iprotonotarios/gondola/README.md

# gondola
A parametric robot infrastructure for repeatable mobile experiments

http://arxiv.org/abs/1601.07457
