iprotonotarios/gondola/3d_parts/nema17_pulley.stl

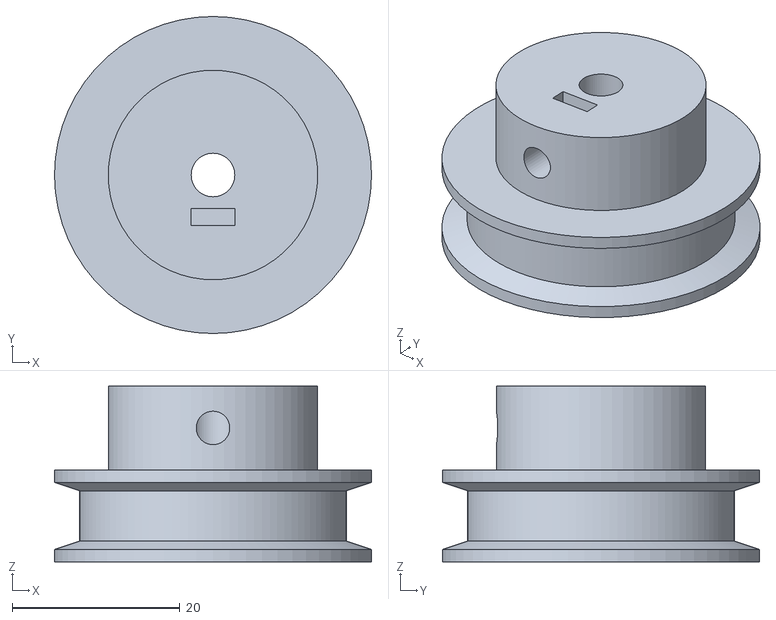
[picture p1: CAD file, 2016-10-17]
3d_parts/nema17_pulley.stl
37.8 x 37.8 x 21.0
