iprotonotarios/gondola/3d_parts/nema17_motor_base.stl

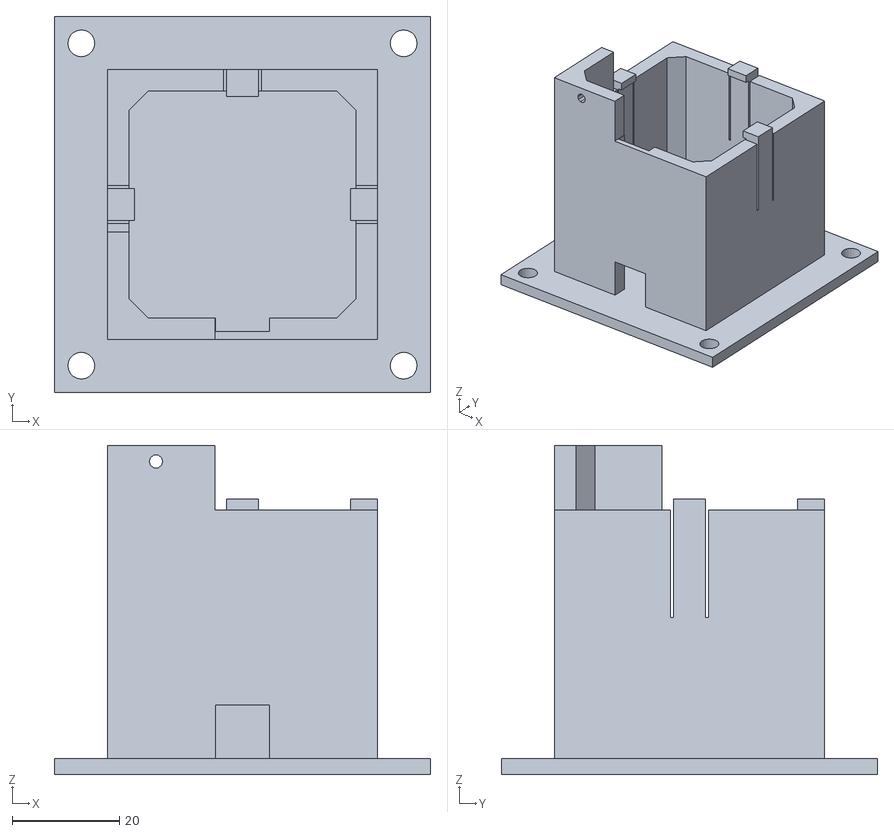
[picture p2: CAD file, 2016-01-28]
3d_parts/nema17_motor_base.stl
70.0 x 70.0 x 61.3
