iprotonotarios/gondola/(list of files, cad)

Other CAD files:
3d_parts/nema17_motor_base.scad
3d_parts/nema17_pulley.scad
