iprotonotarios/gondola/motor_controller/eagle_pcb/gondola.brd

## EAGLE design motor_controller/eagle_pcb/gondola.brd (2016-01-27)

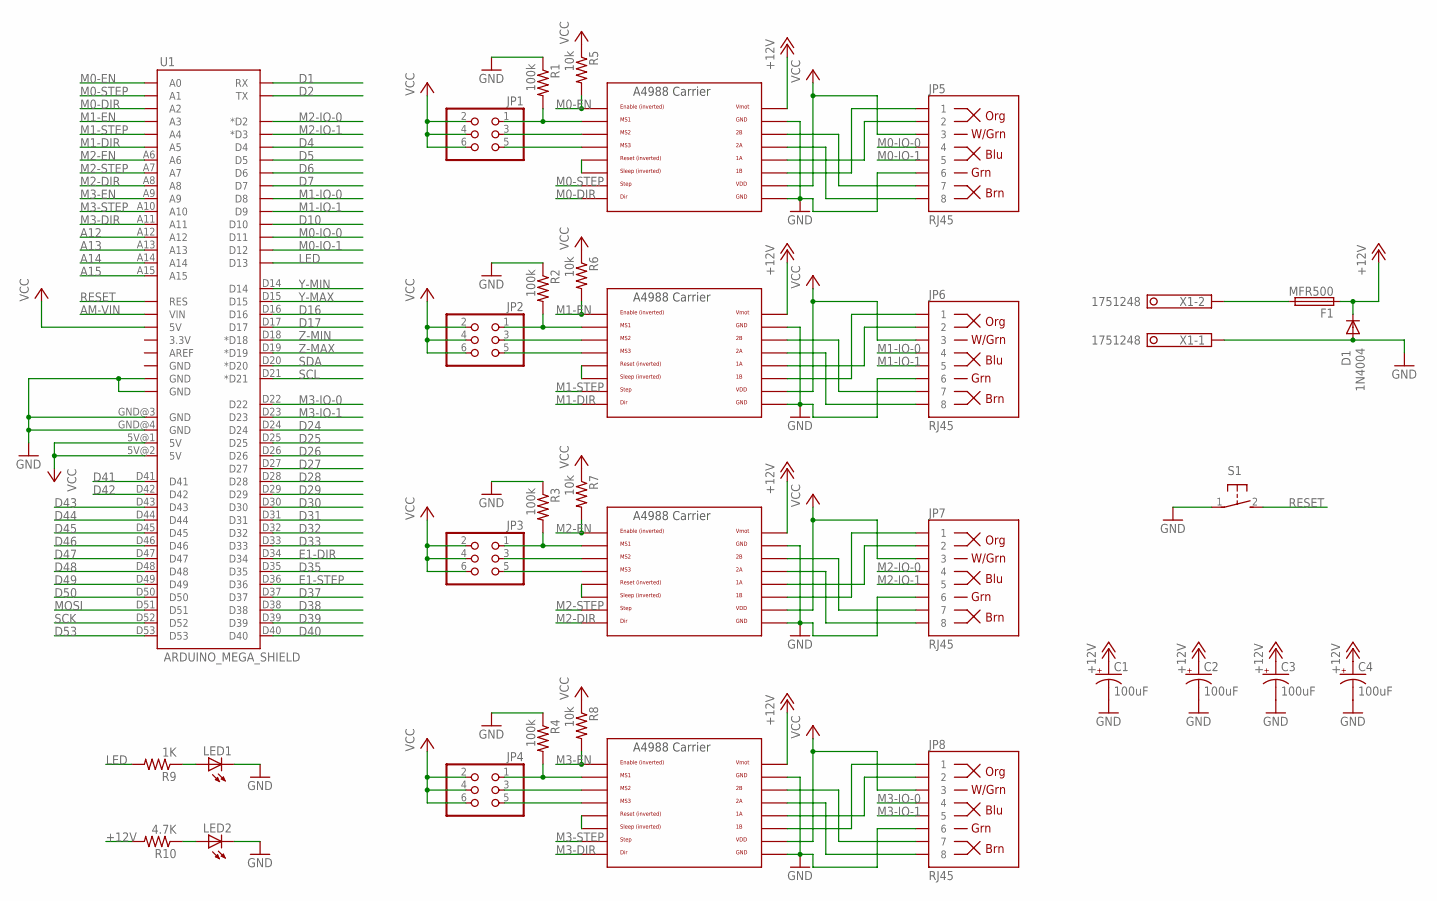
[picture p3: schematic gondola.sch]

Parts:
C1, C2, C3, C4: 100uF; 153CLV-0605
D1: 1N4004; DO41-10
F1: MFR500
JP1, JP2, JP3, JP4: PINHD-2X3; 2X03
JP5, JP6, JP7, JP8: RJ45; RJ45-8
LED1, LED2: LEDCHIP-LED0805; CHIP-LED0805
R1, R2, R3, R4: 100k; R0805
R5, R6, R7, R8: 10k; R0805
R9: 1K; R0805
R10: 4.7K; R0805
S1: 31-XX; B3F-31XX
U1: ARDUINO_MEGA_SHIELD
U$1, U$2, U$3, U$4: A4988BREAKOUT
X1: 1751248

Connections:
+12V: C1.+, C2.+, C3.+, C4.+, D1.C, F1.1, R10.2, U$1.VMOT, U$2.VMOT, U$3.VMOT, U$4.VMOT
A12: U1.A12
A13: U1.A13
A14: U1.A14
A15: U1.A15
AM-VIN: U1.VIN
D1: U1.RX
D2: U1.TX
D4: U1.D4
D5: U1.D5
D6: U1.D6
D7: U1.D7
D10: U1.D10
D16: U1.D16
D17: U1.D17
D24: U1.D24
D25: U1.D25
D26: U1.D26
D27: U1.D27
D28: U1.D28
D29: U1.D29
D30: U1.D30
D31: U1.D31
D32: U1.D32
D33: U1.D33
D35: U1.D35
D37: U1.D37
D38: U1.D38
D39: U1.D39
D40: U1.D40
D41: U1.D41
D42: U1.D42
D43: U1.D43
D44: U1.D44
D45: U1.D45
D46: U1.D46
D47: U1.D47
D48: U1.D48
D49: U1.D49
D50: U1.D50
D53: U1.D53
E1-DIR: U1.D34
E1-STEP: U1.D36
GND: C1.-, C2.-, C3.-, C4.-, D1.A, JP5.6, JP6.6, JP7.6, JP8.6, LED1.C, LED2.C, R1.1, R2.1, R3.1, R4.1, S1.1, U1.GND@0 (GND), U1.GND@1 (GND), U1.GND@3 (GND), U1.GND@4 (GND), U$1.GND, U$1.GND@0 (GND), U$2.GND, U$2.GND@0 (GND), U$3.GND, U$3.GND@0 (GND), U$4.GND, U$4.GND@0 (GND), X1.1
LED: R9.2, U1.D13
M0-DIR: U1.A2, U$4.DIR
M0-EN: R5.2, U1.A0, U$4.EN
M0-IO-0: JP5.4, U1.D11
M0-IO-1: JP5.5, U1.D12
M0-STEP: U1.A1, U$4.STEP
M1-DIR: U1.A5, U$1.DIR
M1-EN: R6.2, U1.A3, U$1.EN
M1-IO-0: JP6.4, U1.D8
M1-IO-1: JP6.5, U1.D9
M1-STEP: U1.A4, U$1.STEP
M2-DIR: U1.A8, U$2.DIR
M2-EN: R7.2, U1.A6, U$2.EN
M2-IO-0: JP7.4, U1.D2 (*D2)
M2-IO-1: JP7.5, U1.D3 (*D3)
M2-STEP: U1.A7, U$2.STEP
M3-DIR: U1.A11, U$3.DIR
M3-EN: R8.2, U1.A9, U$3.EN
M3-IO-0: JP8.4, U1.D22
M3-IO-1: JP8.5, U1.D23
M3-STEP: U1.A10, U$3.STEP
MOSI: U1.D51
unnamed: JP2.5, U$1.MS3
unnamed: U$1.RST, U$1.SLP (SLEEP)
unnamed: JP1.5, U$4.MS3
unnamed: U$4.RST, U$4.SLP (SLEEP)
unnamed: JP1.1, R1.2, U$4.MS1
unnamed: JP1.3, U$4.MS2
unnamed: JP2.1, R2.2, U$1.MS1
unnamed: JP6.7, U$1.2B
unnamed: JP6.8, U$1.2A
unnamed: JP6.1, U$1.1B
unnamed: JP6.2, U$1.1A
unnamed: JP2.3, U$1.MS2
unnamed: JP5.7, U$4.2B
unnamed: JP5.8, U$4.2A
unnamed: JP5.1, U$4.1B
unnamed: JP5.2, U$4.1A
unnamed: JP3.5, U$2.MS3
unnamed: U$2.RST, U$2.SLP (SLEEP)
unnamed: JP3.1, R3.2, U$2.MS1
unnamed: JP3.3, U$2.MS2
unnamed: JP7.7, U$2.2B
unnamed: JP7.8, U$2.2A
unnamed: JP7.1, U$2.1B
unnamed: JP7.2, U$2.1A
unnamed: JP4.5, U$3.MS3
unnamed: U$3.RST, U$3.SLP (SLEEP)
unnamed: JP4.1, R4.2, U$3.MS1
unnamed: JP4.3, U$3.MS2
unnamed: JP8.7, U$3.2B
unnamed: JP8.8, U$3.2A
unnamed: JP8.2, U$3.1A
unnamed: JP8.1, U$3.1B
unnamed: LED2.A, R10.1
unnamed: LED1.A, R9.1
unnamed: F1.2, X1.2
RESET: S1.2 (S), U1.RES
SCK: U1.D52
SCL: U1.D21 (*D21)
SDA: U1.D20 (*D20)
VCC: JP1.2, JP1.4, JP1.6, JP2.2, JP2.4, JP2.6, JP3.2, JP3.4, JP3.6, JP4.2, JP4.4, JP4.6, JP5.3, JP6.3, JP7.3, JP8.3, R5.1, R6.1, R7.1, R8.1, U1.5V@0 (5V), U1.5V@1 (5V), U1.5V@2 (5V), U$1.VDD, U$2.VDD, U$3.VDD, U$4.VDD
Y-MAX: U1.D15
Y-MIN: U1.D14
Z-MAX: U1.D19 (*D19)
Z-MIN: U1.D18 (*D18)

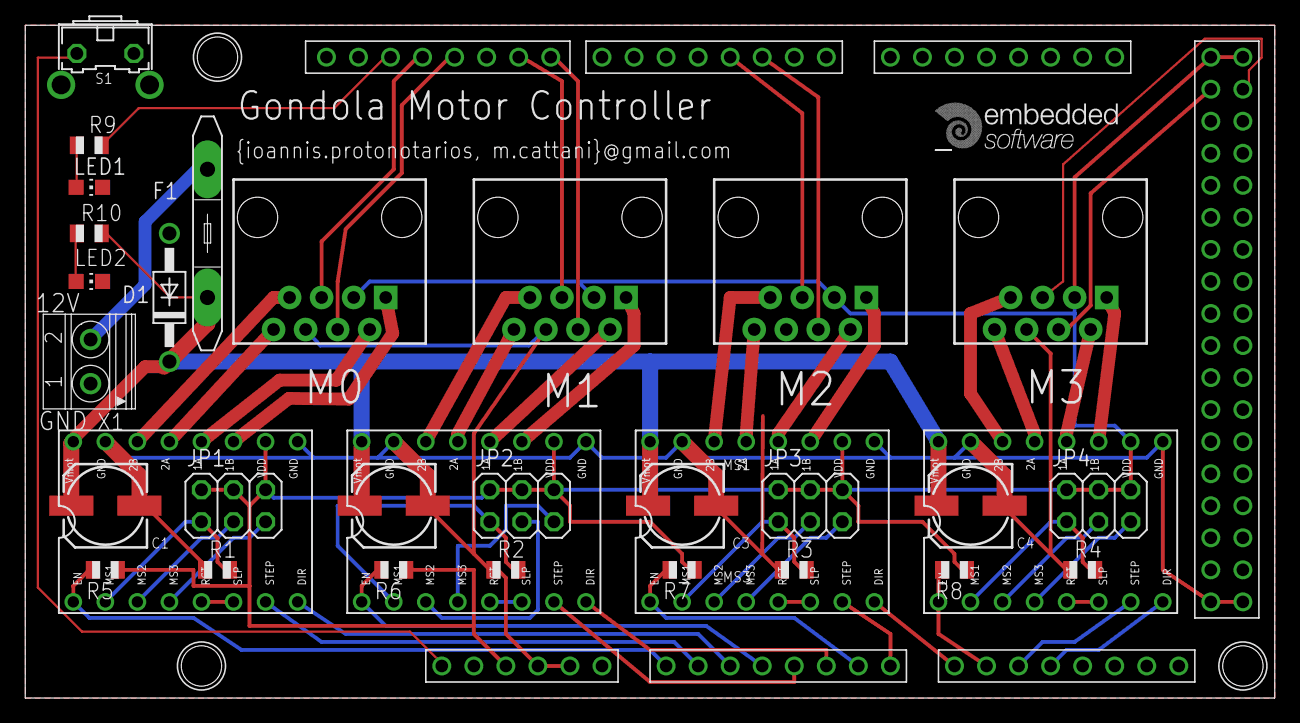
[picture p4: board gondola.brd from above]

Board: 2 copper layers, 99.0 x 53.3 mm, 33 parts (0 on the bottom side), 60 nets.
