iprotonotarios/gondola/(commit log)

2016-01-28 added 3d-printed parts
    [nema17_motor_base.scad, nema17_motor_base.stl, nema17_pulley.scad, nema17_pulley.stl]
2016-08-30 new motor controller
2016-09-08 liner motion arduino
    added linear motion to arduino
2016-10-07 complete smooth engine motors
    [nema17_pulley.stl]
2016-10-07 Fixed floating point movement
    [Anchor.pde, arduino_code.ino, system_controller.pde]
2016-10-14 added heatmap plotting
2017-07-10 added Arduino stand-alone version of gondola
2017-07-10 fixed initial spooling distance
    [arduino_controller.ino]
